sendevo/registrador-dinamometrico/readme.md

# Registrador dinamométrico para maquinarias agropecuarias

Dispositivo para el registro de datos de cuatro canales para celdas de cargas y cinco canales para contadores de pulso. El registrador se aplica para la medición de esfuerzos de tracción y velocidades de rotación de ejes o ruedas de maquinaria agrícola.

Está diseñado para alimentarse con batería de 12V, tolerancia para conexión invertida y con caída de tensión de hasta 10V. Posee reloj interno con vida útil de más de 5 años, almacenamiento de datos de hasta 4GB y conexión USB para la descarga de datos.

Se incluye el software para la configuración del registrador:
   - Listado de registros almacenados.  
   - Descarga de registros.  
   - Eliminación de registros.  
   - Lectura de celdas de carga.  
   - Configuración de fecha y hora.  

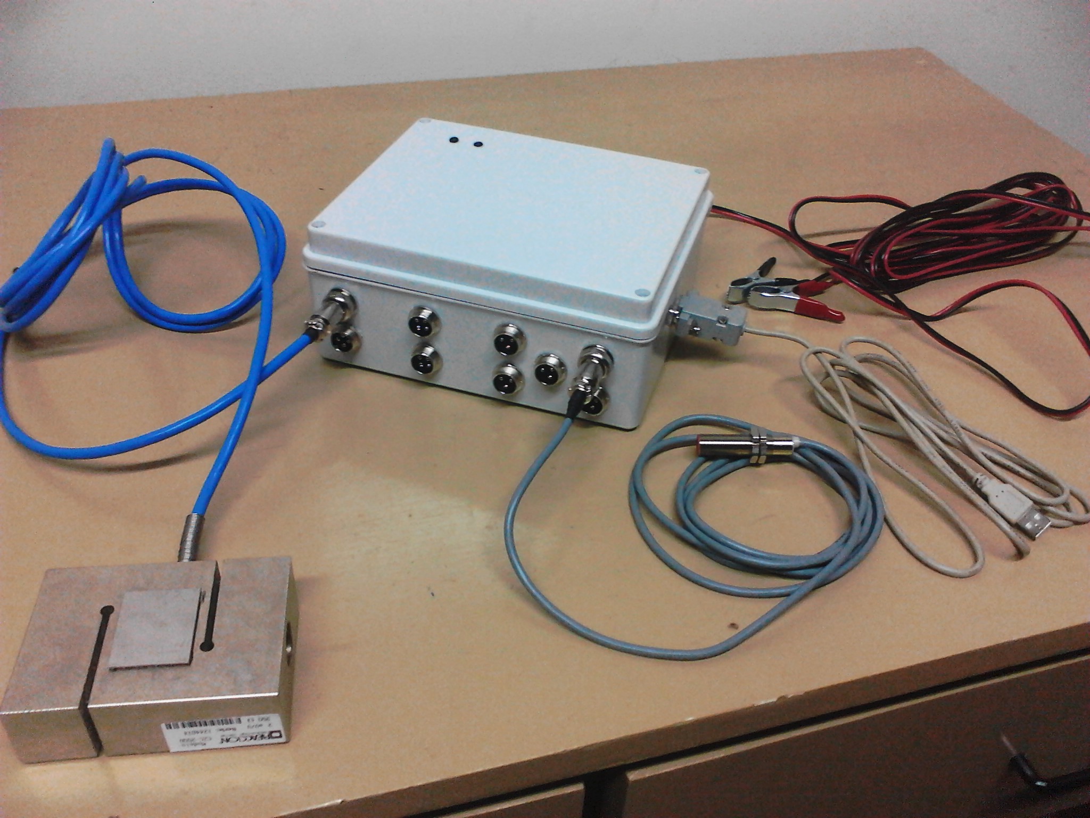
[picture p1: documentacion/fotos/IMG_20151119_213634.jpg]


## Esquema de bloques genérico
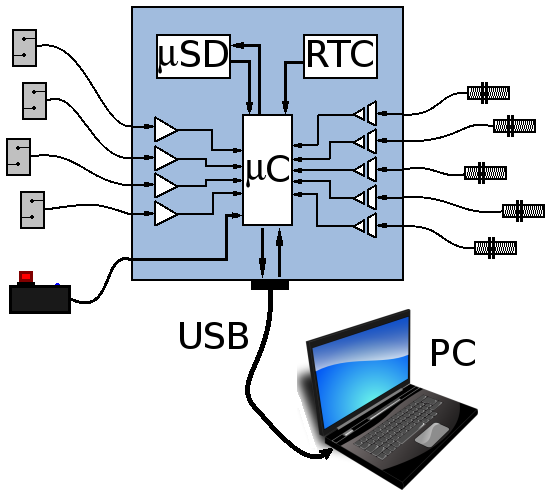
[picture p2: documentacion/manual-assets/Diagrama.png]


## Placa madre
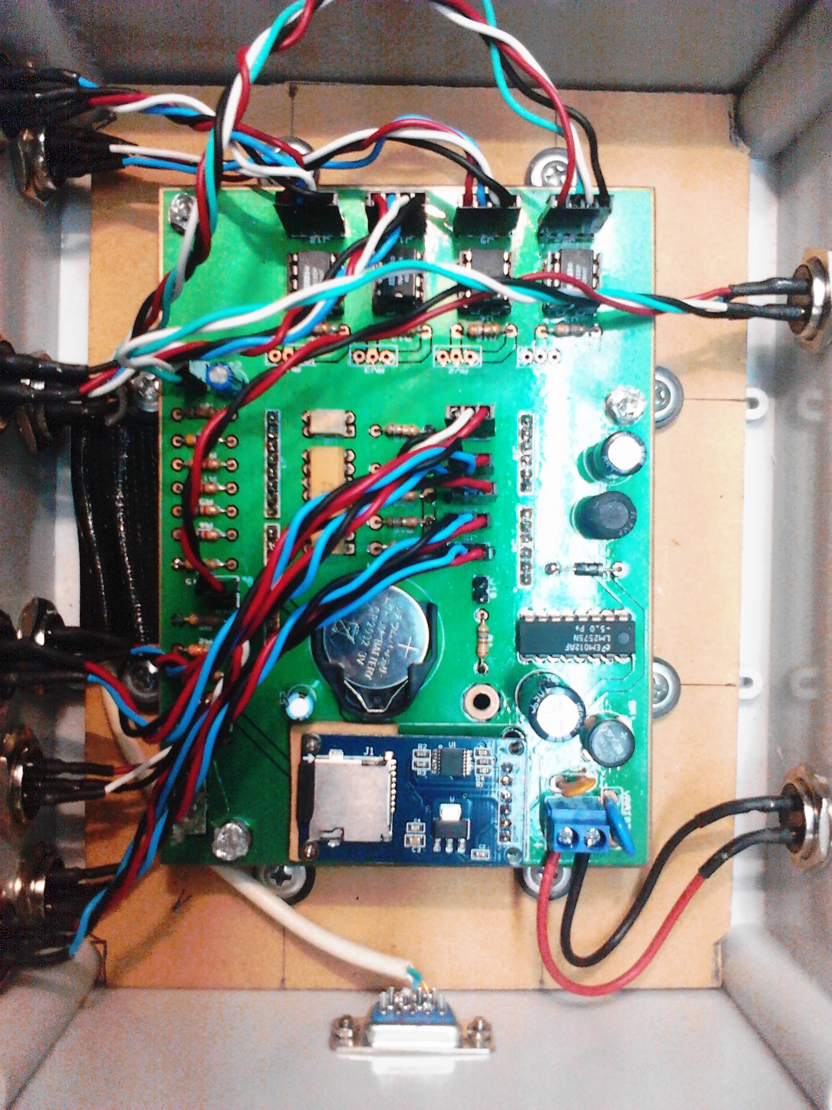
[picture p3: documentacion/fotos/IMG_20151201_174024.jpg]


## Circuito de celdas de carga
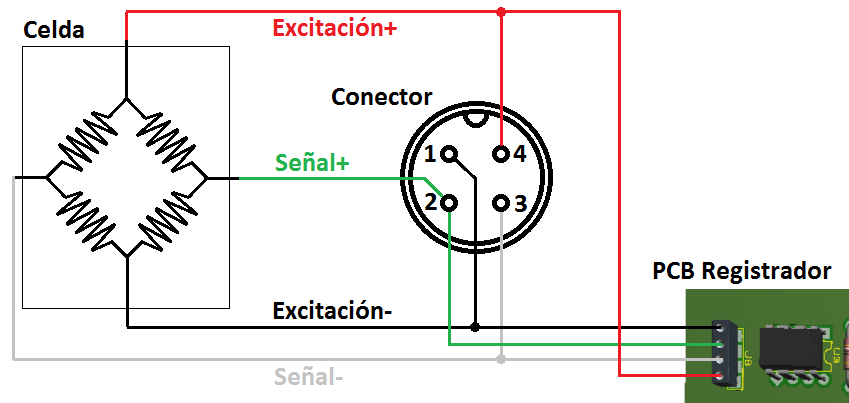
[picture p4: documentacion/manual-assets/ConectorCeldas.png]


## Circuito de contadores de pulso
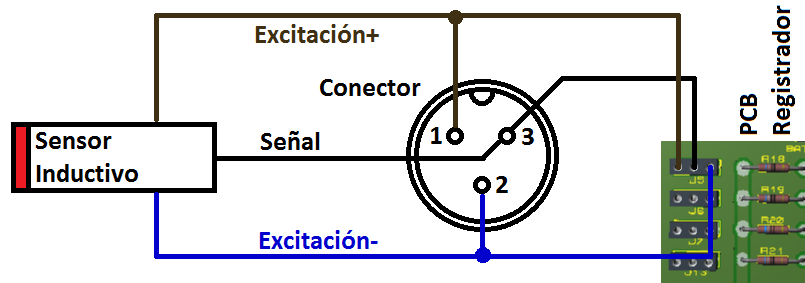
[picture p5: documentacion/manual-assets/ConectorInductivos.png]


## Versión actualizada

La nueva versión incluye un display de 20x4 para mostrar estado de las entradas en el caso de requerir mediciones no periódicas. Cuando el switch de activación se enciende, el display indica que el registrador se encuentra en modo de medición y registro de datos.  
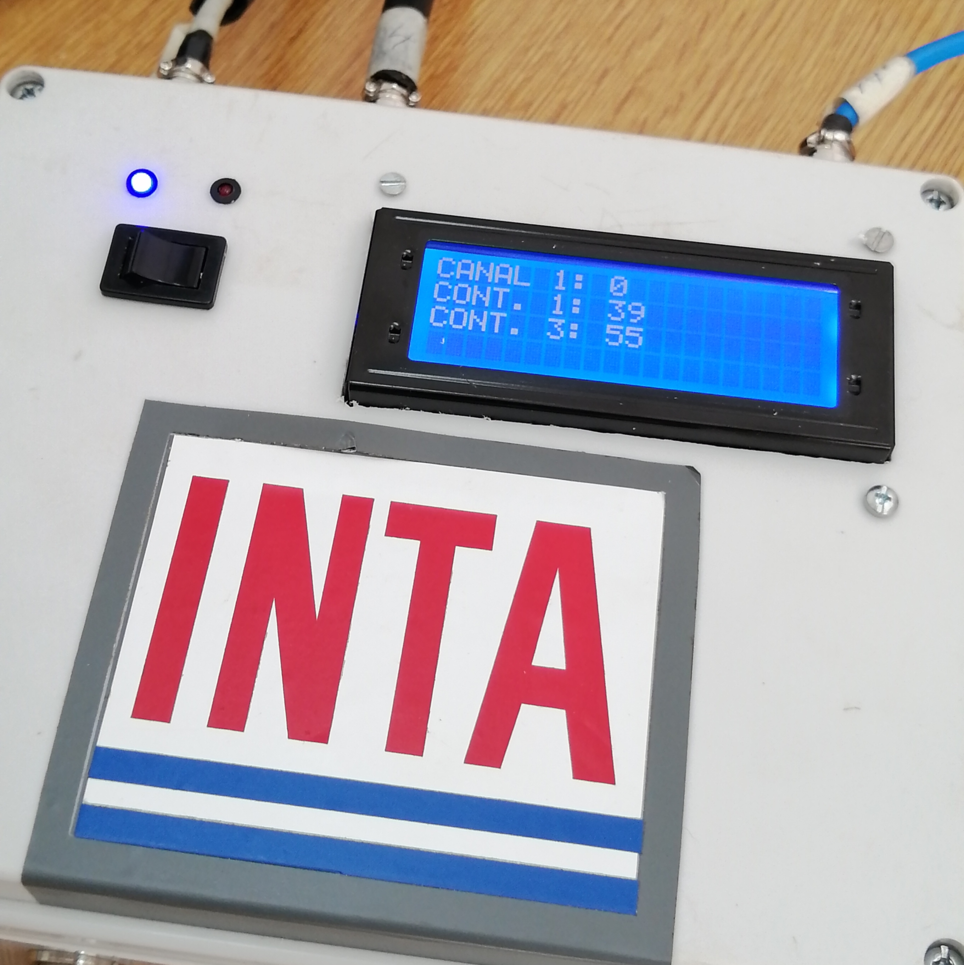
[picture p6: documentacion/fotos/IMG_20230531_140004_sq.jpg]


## Creación del ejecutable para windows

```bash
pyinstaller --onefile --windowed --icon=app_icon.ico --add-data "assets;assets" main.py
```
