sendevo/registrador-dinamometrico/documentacion/jaiio-cai-2016/slides-cai-2016.pdf

Diseño de un
Registrador de
Esfuerzos para
Maquinaria Agrícola

Introducción

Hardware
- Plataforma
- Medición de RPM
- Medición de
esfuerzos de
tracción
- Fuente de
alimentación
- Montaje

Software
- Firmware
- Software PC

Pruebas
experimentales

Conclusiones

# Diseño de un Registrador de Esfuerzos para Maquinaria Agrícola

# Gabriel M. Eggly – Matías J. Micheletto – Rodrigo M. Santos

# Dep. Ing. Eléctrica y Computadoras IIIE - Universidad Nacional del Sur CONICET

Diseño de un
Registrador de
Esfuerzos para
Maquinaria Agrícola

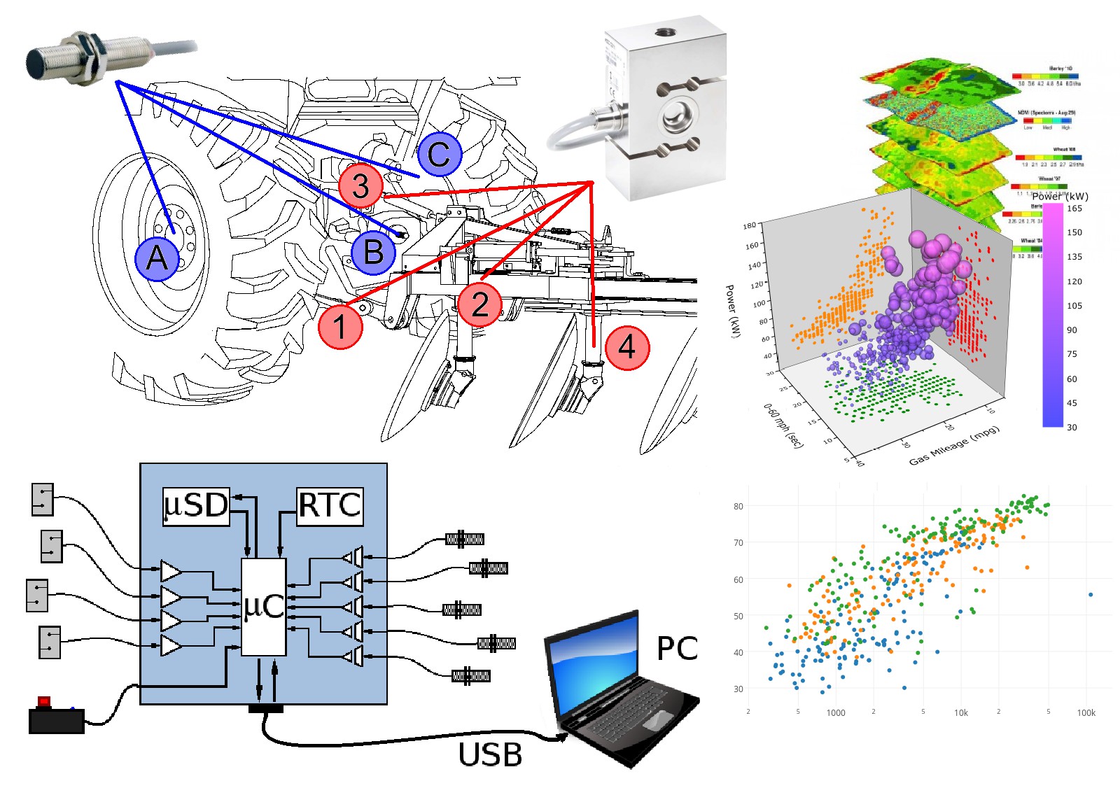
[picture p15: figure]

Introducción

Hardware
- Plataforma
- Medición de RPM
- Medición de
esfuerzos de
tracción
- Fuente de
alimentación
- Montaje

Software
- Firmware
- Software PC

Pruebas
experimentales

Conclusiones

# Introducción

Diseño de un
Registrador de
Esfuerzos para
Maquinaria Agrícola

Introducción

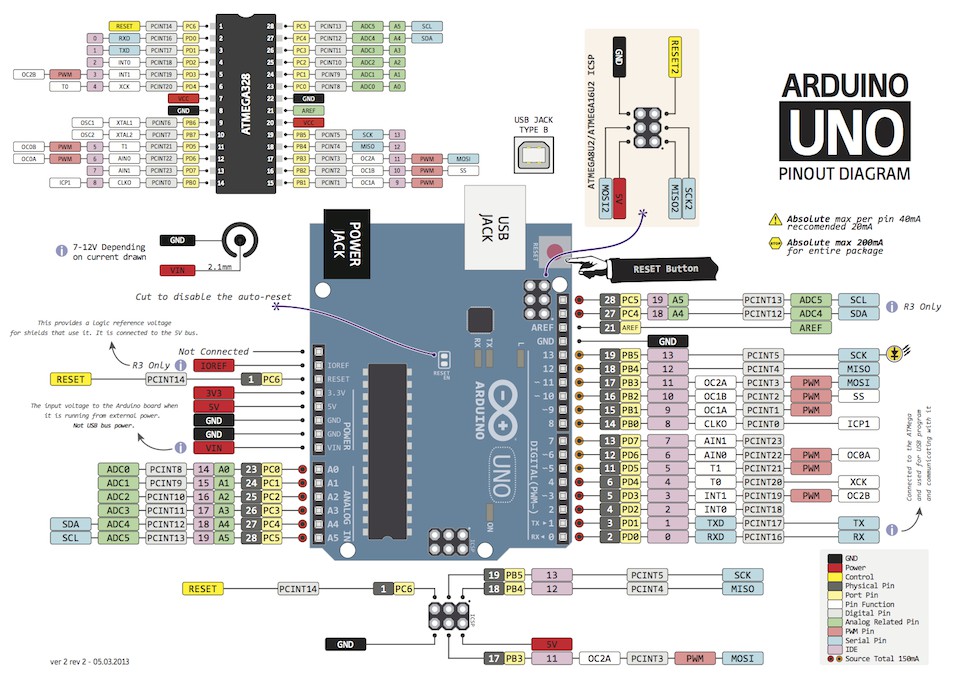
[picture p16: figure]

Hardware
- Plataforma
- Medición de RPM
- Medición de
esfuerzos de
tracción
- Fuente de
alimentación
- Montaje

Software
- Firmware
- Software PC

Pruebas
experimentales

Conclusiones

# Hardware

# Plataforma

Diseño de un
Registrador de
Esfuerzos para
Maquinaria Agrícola

Introducción

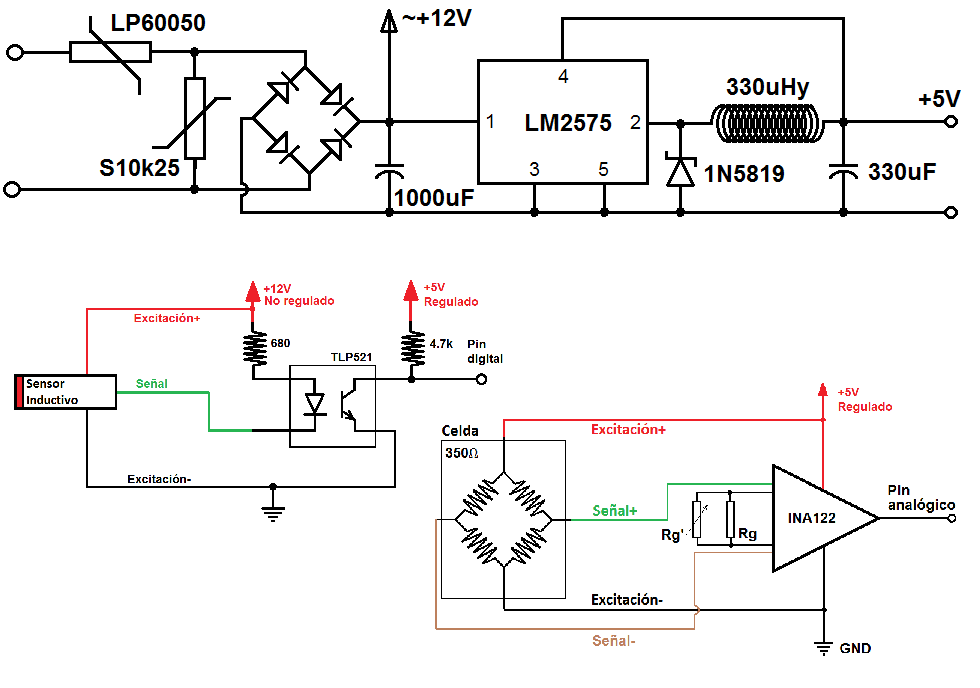
[picture p17: figure]

Hardware
- Plataforma
- Medición de RPM
- Medición de
esfuerzos de
tracción
- Fuente de
alimentación
- Montaje

Software
- Firmware
- Software PC

Pruebas
experimentales

Conclusiones

# Hardware

# Fuente de alimentación y sensores

Diseño de un
Registrador de
Esfuerzos para
Maquinaria Agrícola

Introducción

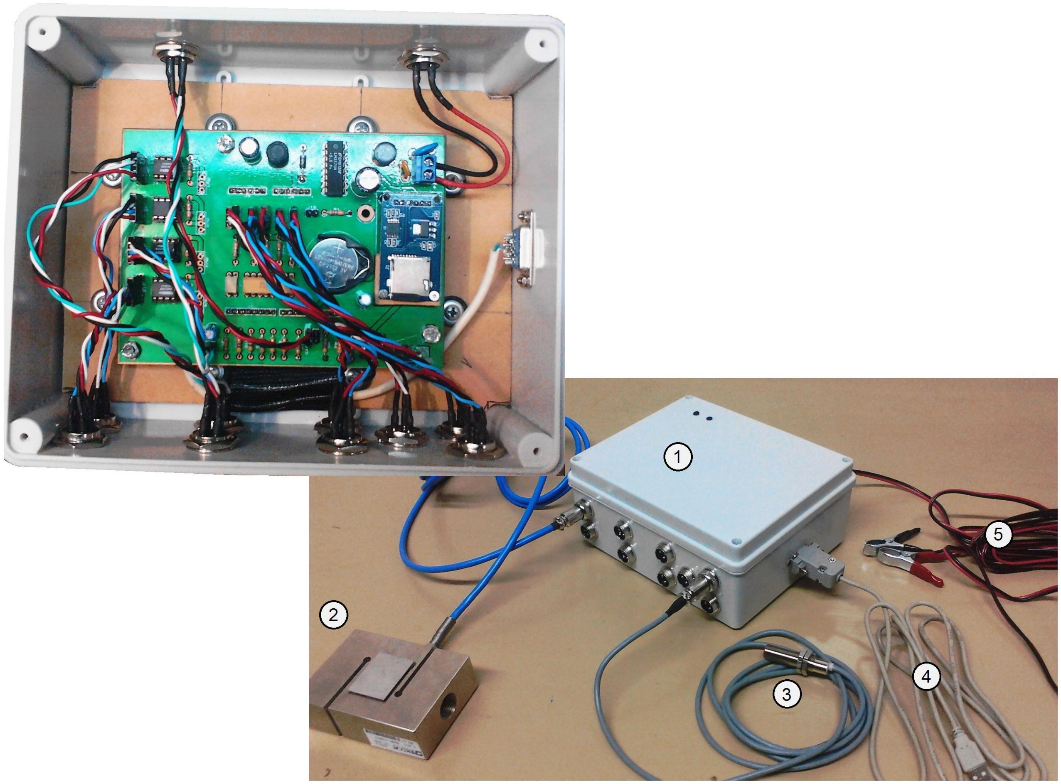
[picture p18: figure]

Hardware
- Plataforma
- Medición de RPM
- Medición de
esfuerzos de
tracción
- Fuente de
alimentación
- Montaje

Software
- Firmware
- Software PC

Pruebas
experimentales

Conclusiones

# Hardware

# Montaje

# Software

# Firmware

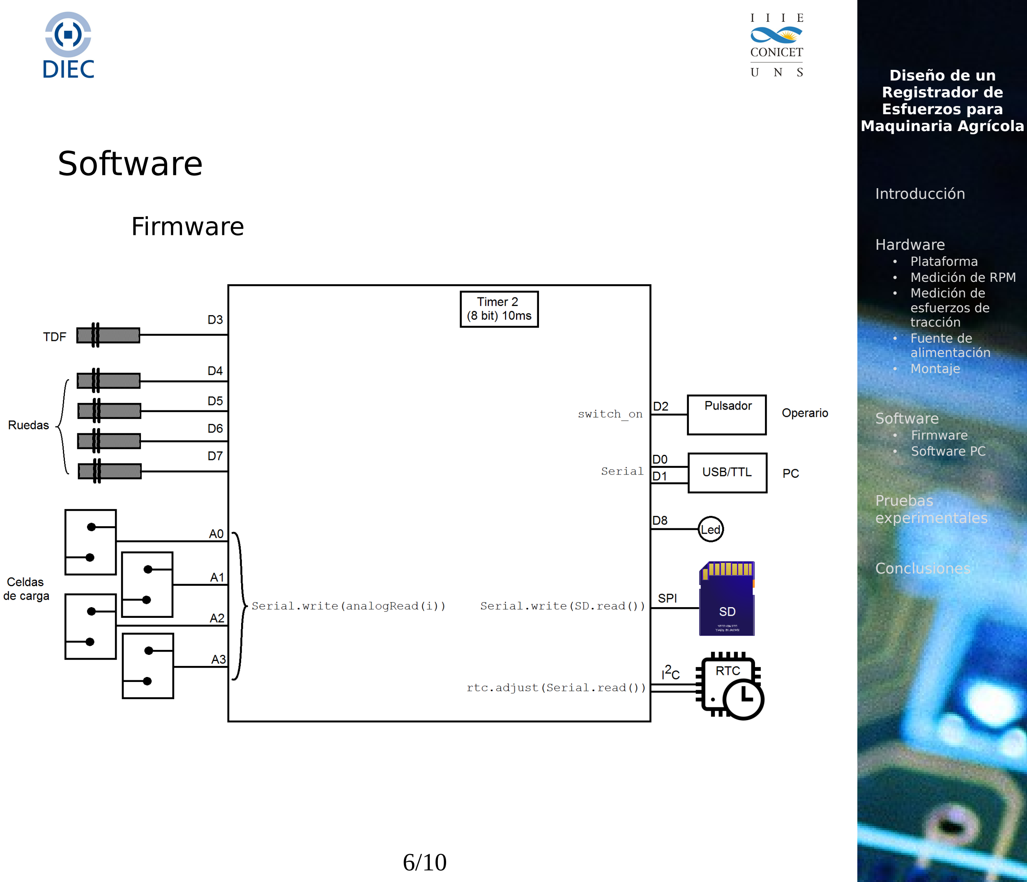
[picture p19: page 6]

Diseño de un
Registrador de
Esfuerzos para
Maquinaria Agrícola

Introducción

Hardware
- Plataforma
- Medición de RPM
- Medición de
esfuerzos de
tracción
- Fuente de
alimentación
- Montaje

Software
- Firmware
- Software PC

Pruebas
experimentales

Conclusiones

# Software

# Firmware

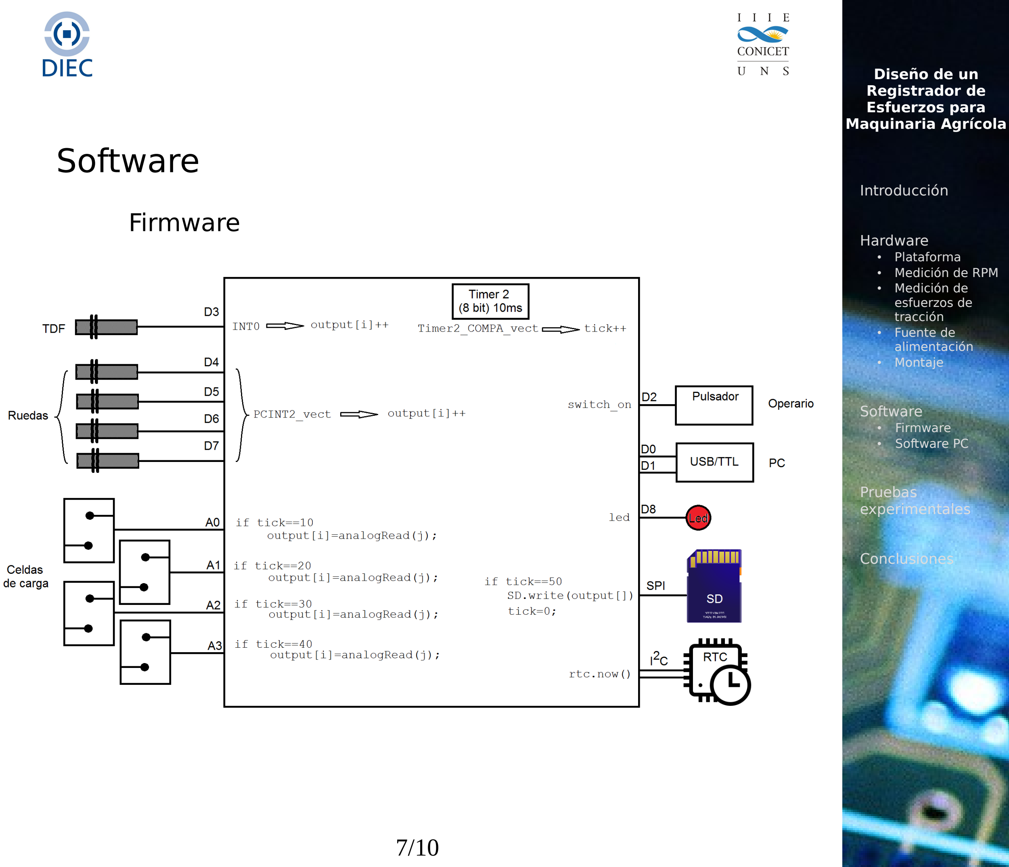
[picture p20: page 7]

Diseño de un
Registrador de
Esfuerzos para
Maquinaria Agrícola

Introducción

Hardware
- Plataforma
- Medición de RPM
- Medición de
esfuerzos de
tracción
- Fuente de
alimentación
- Montaje

Software
- Firmware
- Software PC

Pruebas
experimentales

Conclusiones

# Software

# Driver para PC

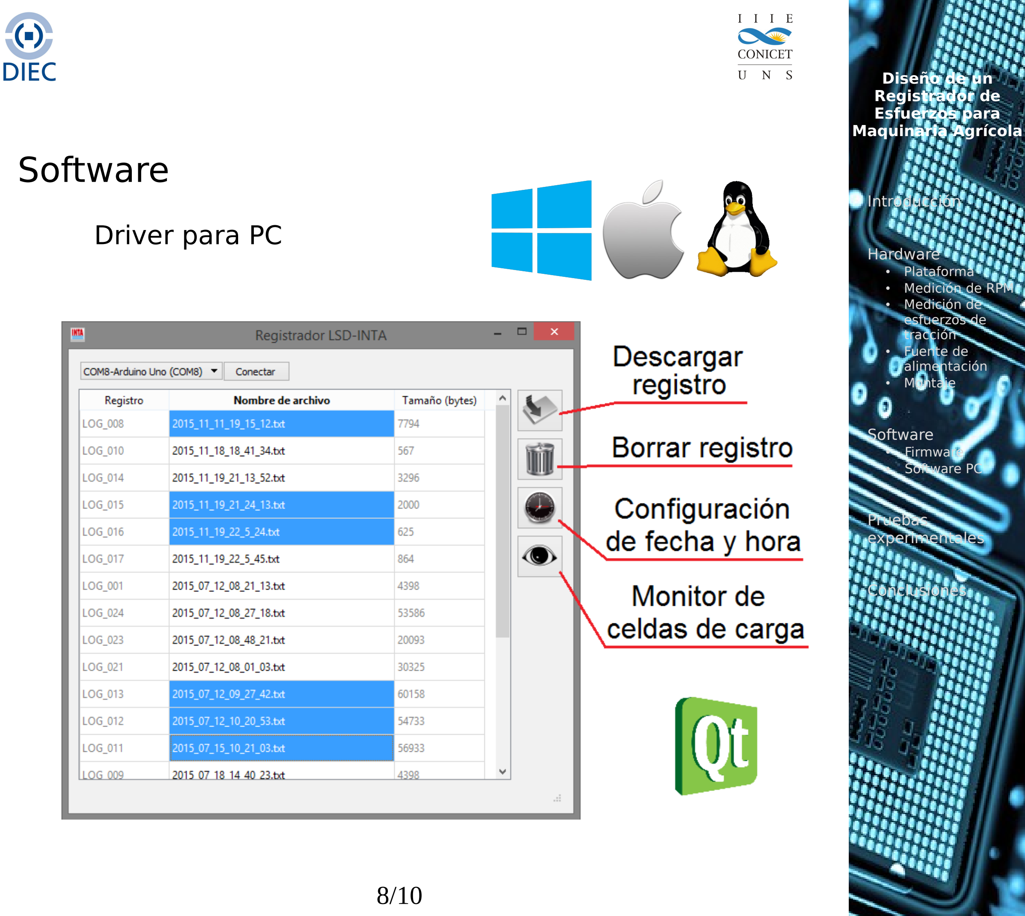
[picture p21: page 8]

Diseño de un
Registrador de
Esfuerzos para
Maquinaria Agrícola

Introducción

Hardware
- Plataforma
- Medición de RPM
- Medición de
esfuerzos de
tracción
- Fuente de
alimentación
- Montaje

Software
- Firmware
- Software PC

Pruebas
experimentales

Conclusiones

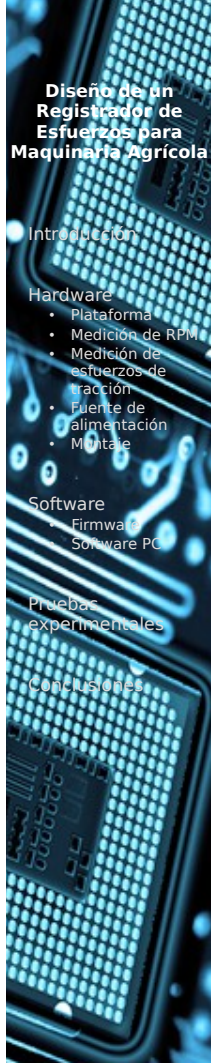
[picture p22: figure]
Diseño de un Registrador de Esfuerzos para Maquinaria Agrícola; Introducción; Hardware • Plataforma • Medición de RPM • Medición de esfuerzos de tracción • Fuente de alimentación • Montaje; Software • Firmware • Software PC; Pruebas experimentales; Conclusiones

# Conclusiones

- Diseño simple y económico.
- Fácil instalación, puesta en marcha y uso.

# - No requiere software específico para la descarga de

datos (protocolo de comunicación abierto).

# - Requiere software adicional para el análisis de los

datos.

Diseño de un
Registrador de
Esfuerzos para
Maquinaria Agrícola

Introducción

Hardware
- Plataforma
- Medición de RPM
- Medición de
esfuerzos de
tracción
- Fuente de
alimentación
- Montaje

Software
- Firmware
- Software PC

Pruebas
experimentales

Conclusiones

# Diseño de un Registrador de Esfuerzos para Maquinaria Agrícola

# Gabriel M. Eggly – Matías J. Micheletto – Rodrigo M. Santos

# Dep. Ing. Eléctrica y Computadoras IIIE - Universidad Nacional del Sur CONICET
