sendevo/registrador-dinamometrico/documentacion/fotos/IMG_20151119_201550.jpg

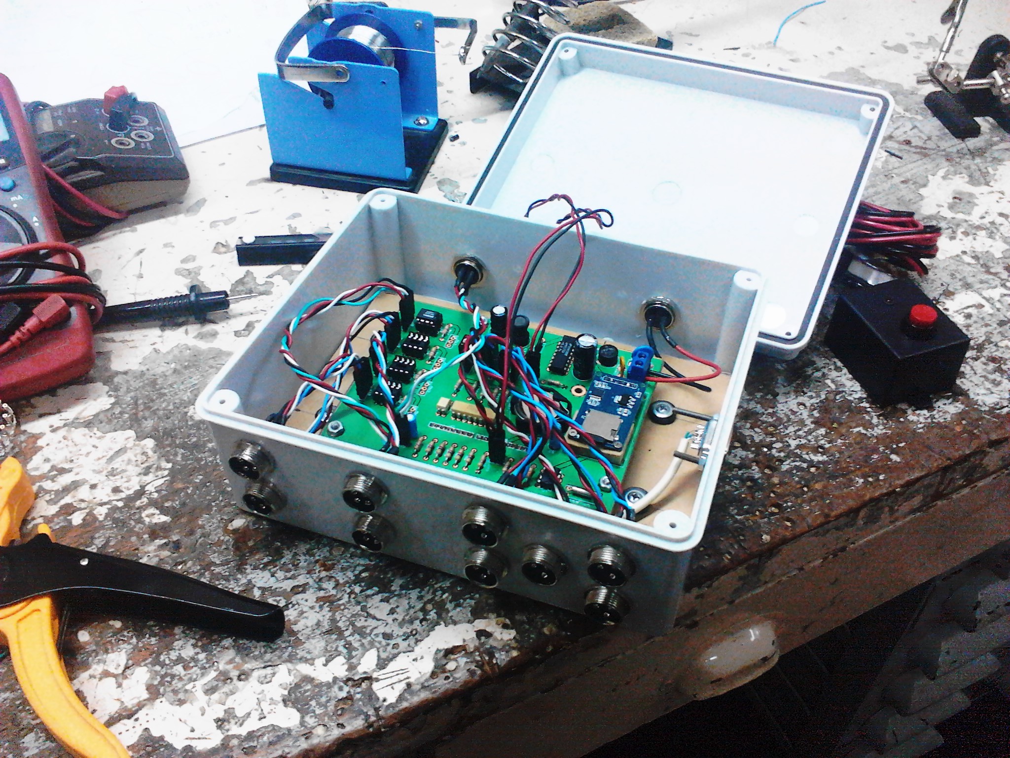
documentacion/fotos/IMG_20151119_201550.jpg
