sendevo/registrador-dinamometrico/documentacion/fotos/IMG_20230531_140004.jpg

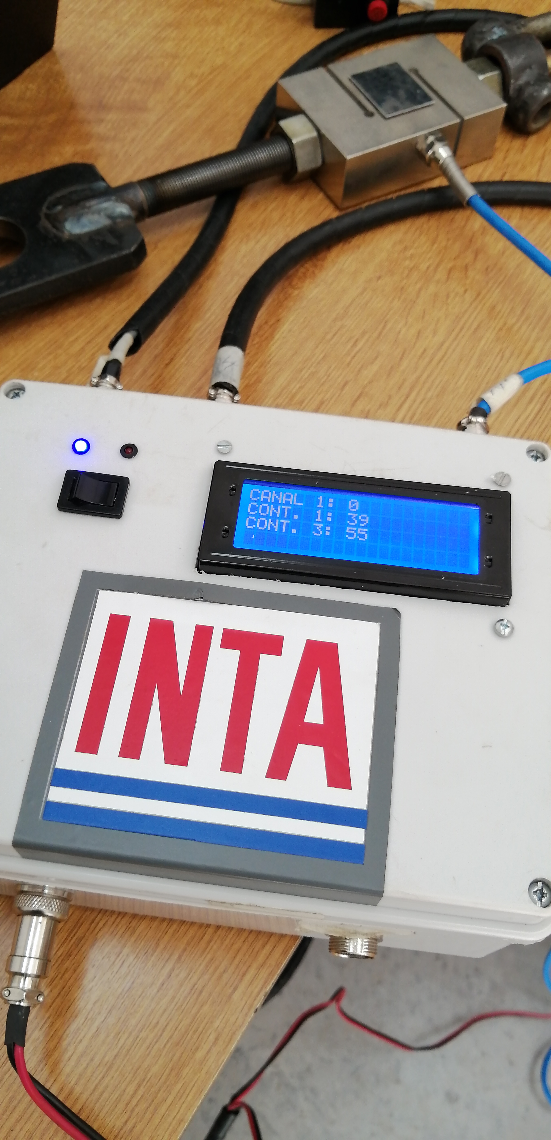
documentacion/fotos/IMG_20230531_140004.jpg
