sendevo/registrador-dinamometrico/software/windows-vs/Inta.png

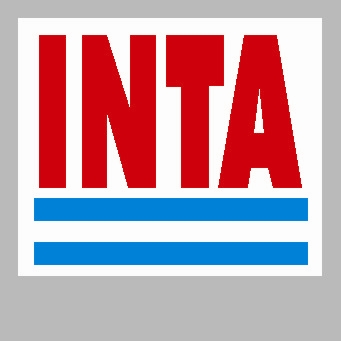
software/windows-vs/Inta.png
