sendevo/registrador-dinamometrico/documentacion/manual-assets/2_ListaArchivos.png

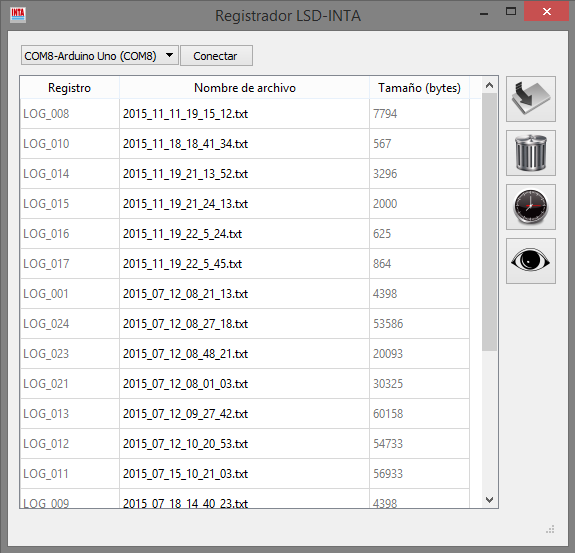
documentacion/manual-assets/2_ListaArchivos.png
