sendevo/registrador-dinamometrico/documentacion/manual-assets/CarcasaRegistrado3.png

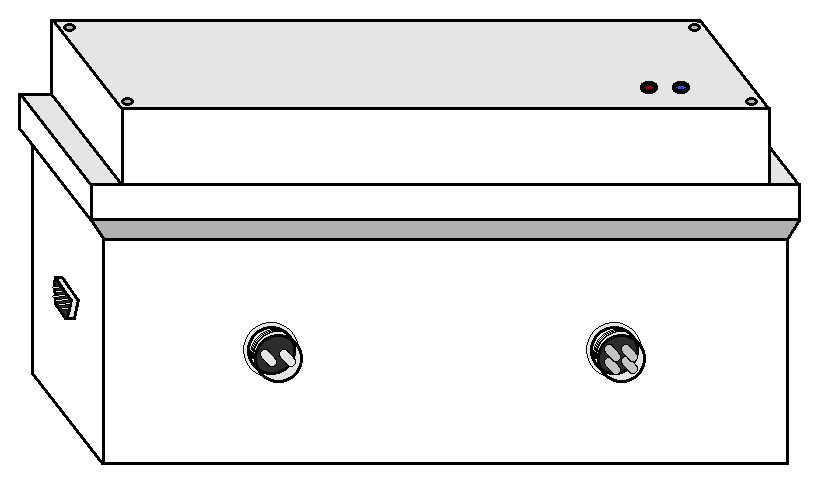
documentacion/manual-assets/CarcasaRegistrado3.png
