sendevo/registrador-dinamometrico/documentacion/manual-assets/CarcasaRegistrado6.png

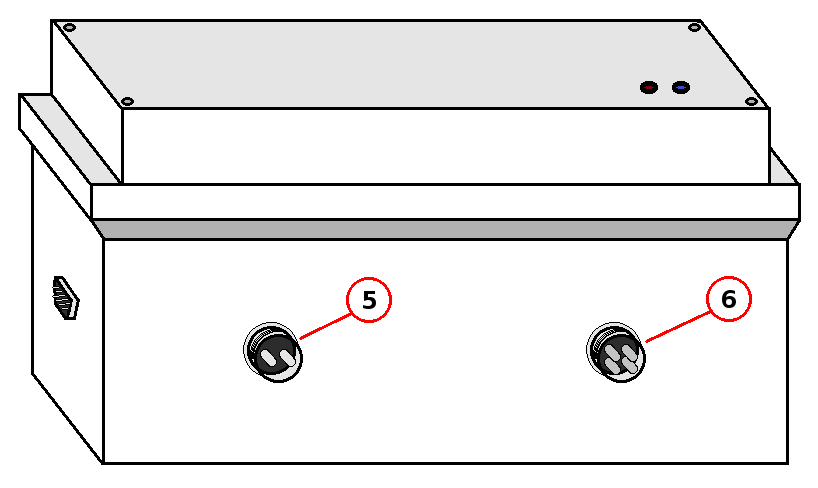
documentacion/manual-assets/CarcasaRegistrado6.png
