sendevo/registrador-dinamometrico/documentacion/manual-assets/CarcasaRegistrador2.png

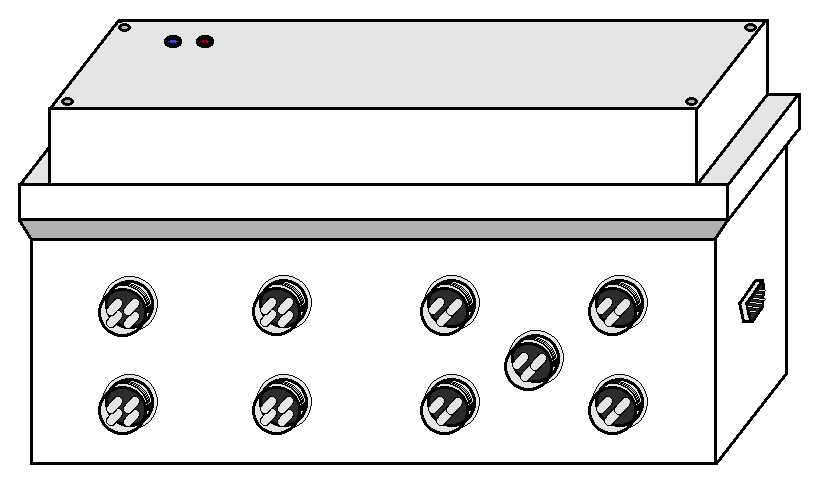
documentacion/manual-assets/CarcasaRegistrador2.png
