sendevo/registrador-dinamometrico/documentacion/manual-assets/CarcasaRegistrador5.png

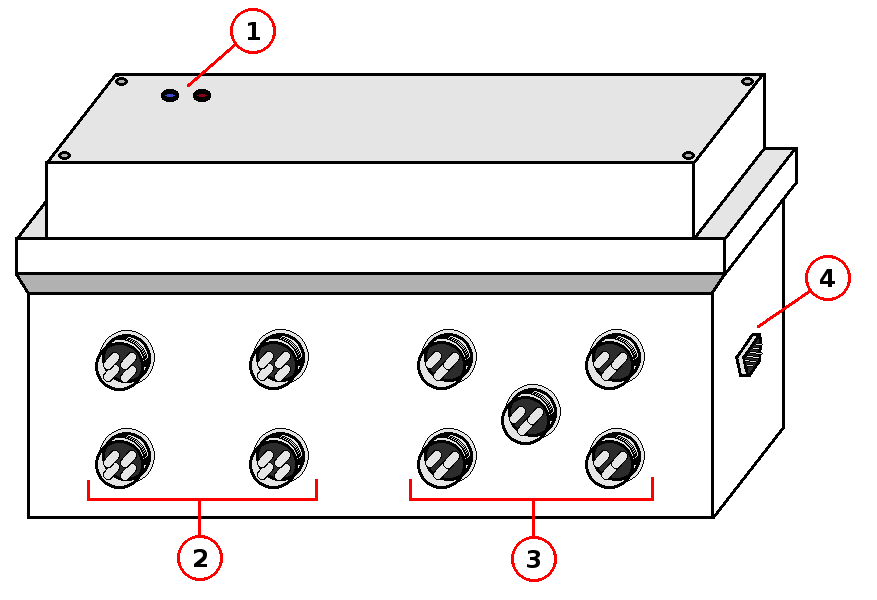
documentacion/manual-assets/CarcasaRegistrador5.png
