sendevo/registrador-dinamometrico/documentacion/manual-assets/CarcasaRegistrador.png

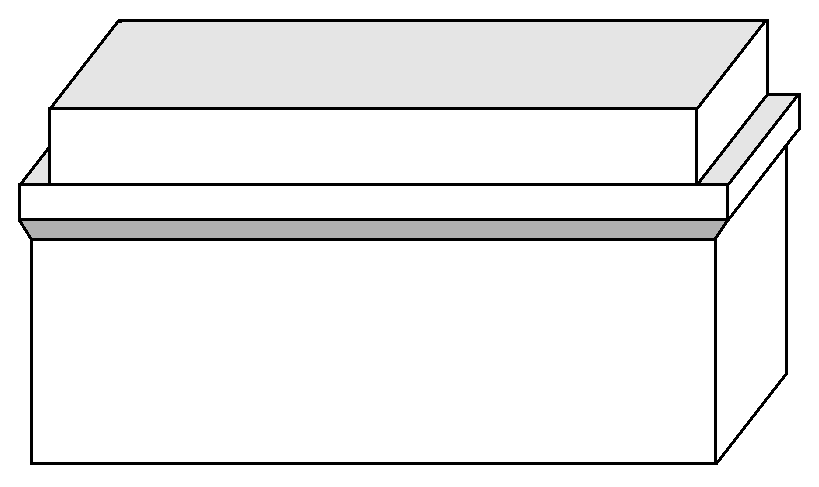
documentacion/manual-assets/CarcasaRegistrador.png
