sendevo/registrador-dinamometrico/documentacion/manual-assets/Catalex-MicroSD-Module.png

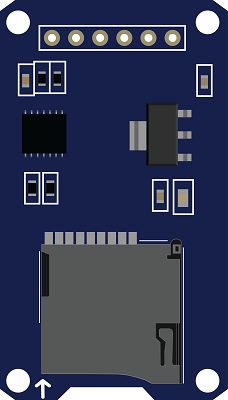
documentacion/manual-assets/Catalex-MicroSD-Module.png
