sendevo/registrador-dinamometrico/documentacion/manual-assets/Conectores.png

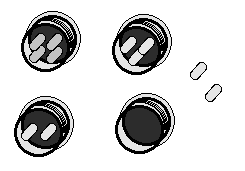
documentacion/manual-assets/Conectores.png
