sendevo/registrador-dinamometrico/documentacion/manual-assets/Connector-db9.png

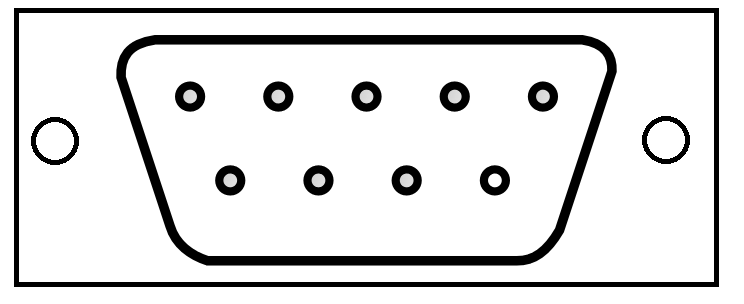
documentacion/manual-assets/Connector-db9.png
