sendevo/registrador-dinamometrico/documentacion/manual-assets/Pulsador.png

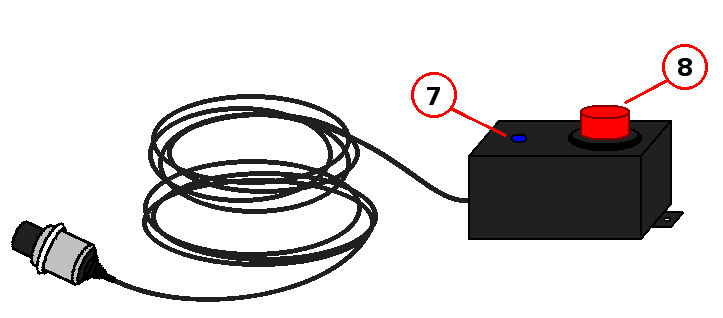
documentacion/manual-assets/Pulsador.png
