sendevo/registrador-dinamometrico/documentacion/manual-assets/UNS.png

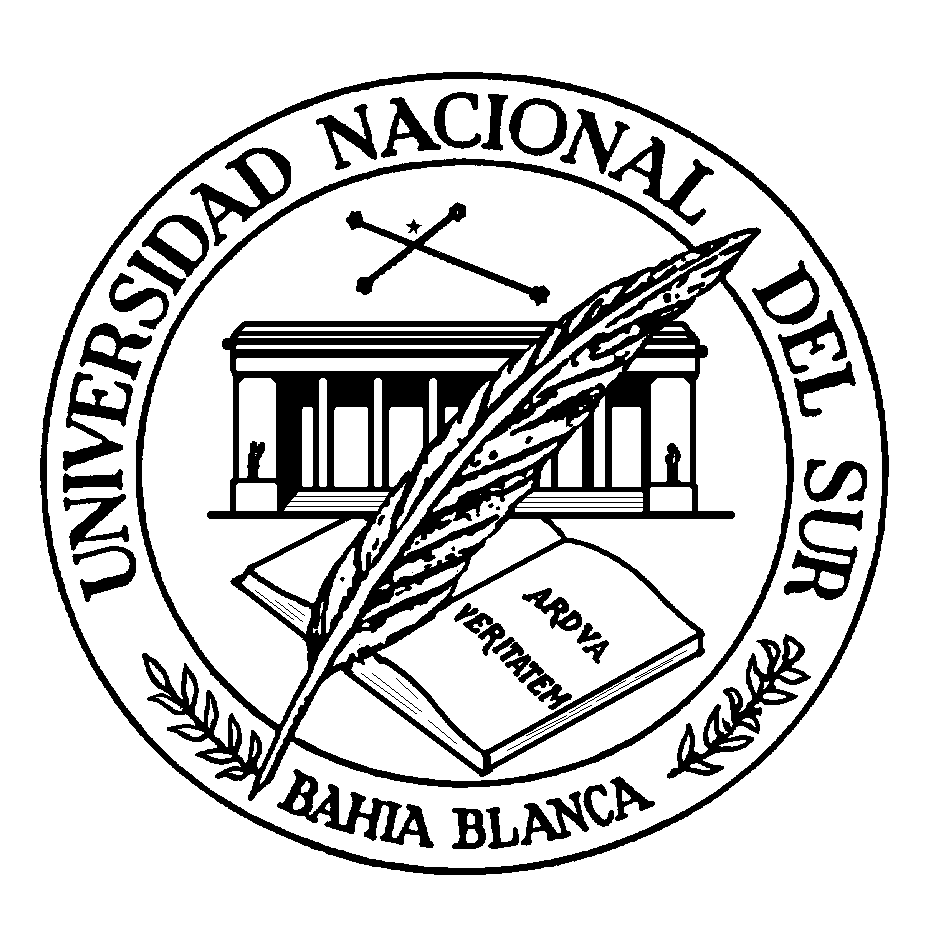
documentacion/manual-assets/UNS.png
