sendevo/registrador-dinamometrico/hardware/caja-estanca.pdf

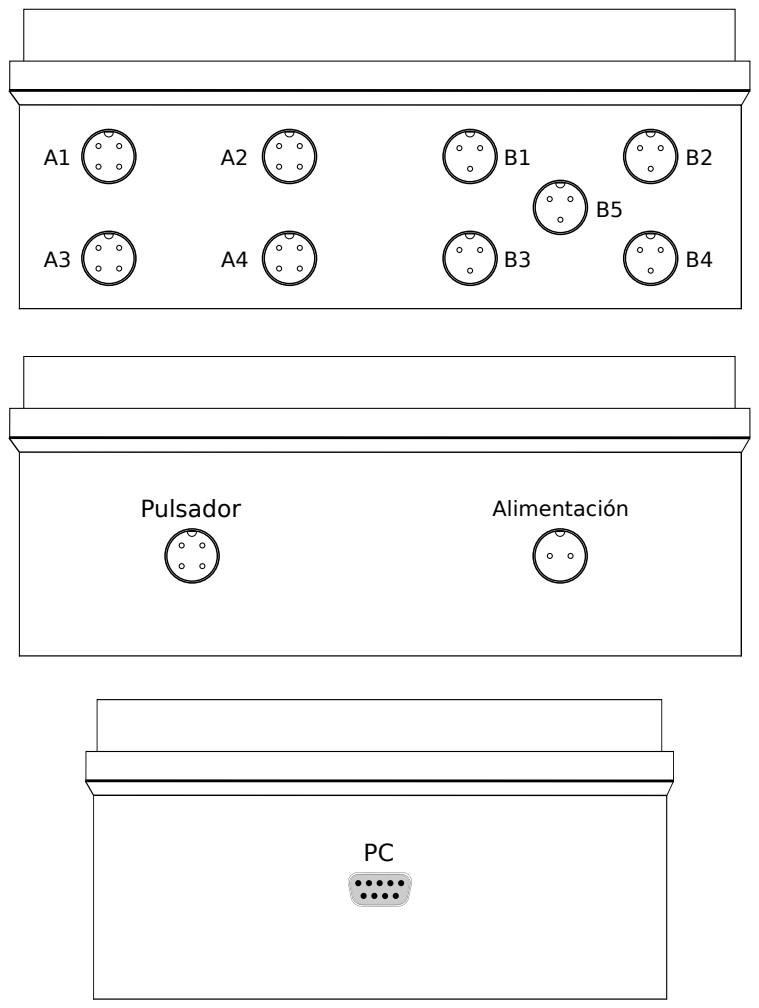
[picture p48: page 1]
Pulsador; Alimentación
