sendevo/registrador-dinamometrico/hardware/pcb-inferior.pdf

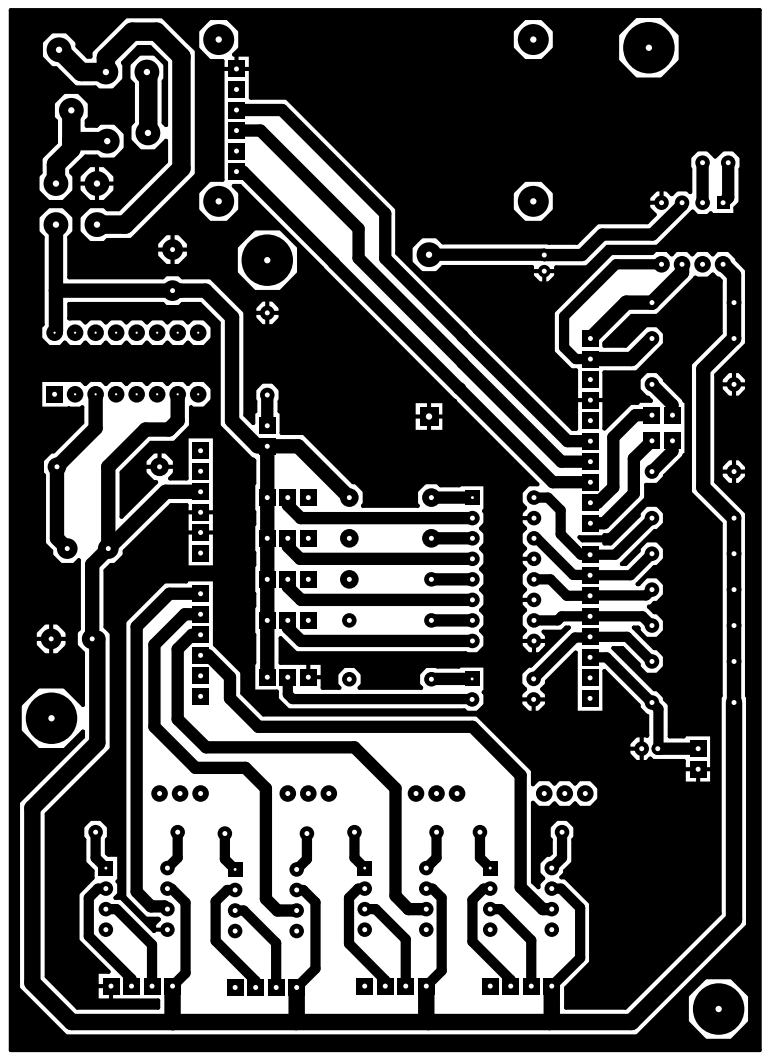
[picture p49: page 1]
