sendevo/registrador-dinamometrico/hardware/pcb-superior.pdf

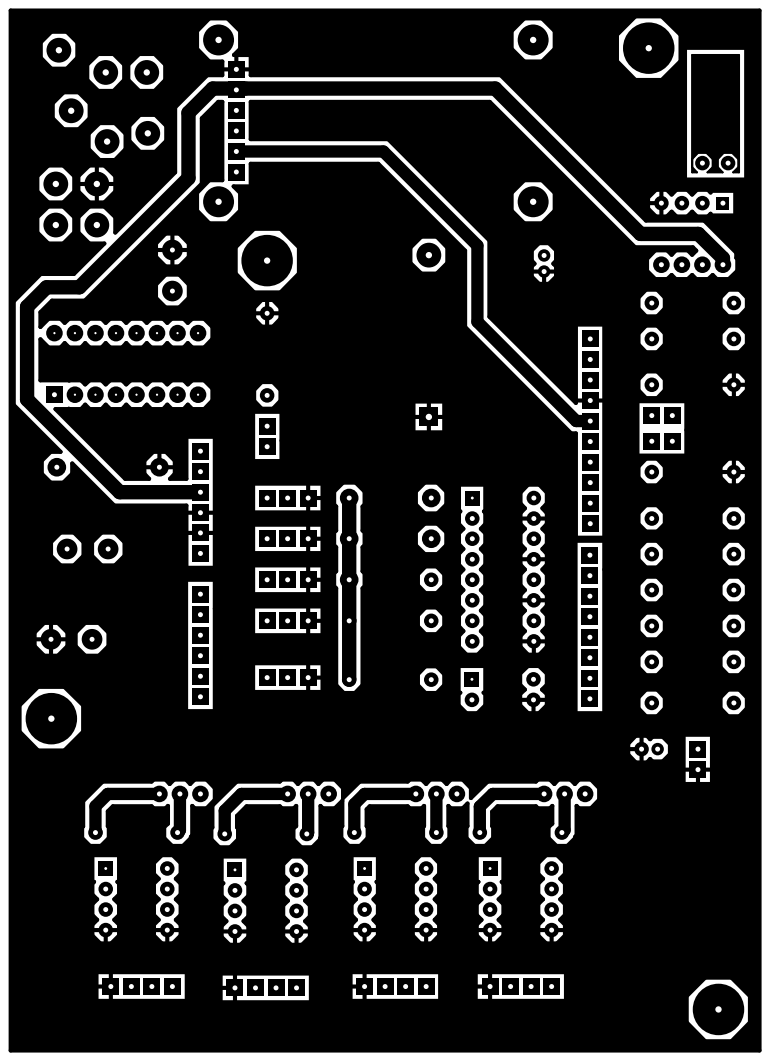
[picture p50: page 1]
