sendevo/registrador-dinamometrico/(list of files, drawings)

Other design files:
hardware/proteus-harware.pdsprj
