sendevo/registrador-dinamometrico/(commit log)

2025-04-28 Contenido del proyecto 2016
    [proteus-harware.pdsprj]
2025-05-05 Software windows: ventana en blanco y snippets de ejemplos
2025-05-05 Combobox para seleccionar puerto serie
2025-05-05 Version 2 del firmware. Firmware emulador para probar comunicacion con el software.
2025-05-05 Fix dict en app_setup. Funcion de descarga de registros
    [main.py]
2025-05-06 Nuevos componentes de la ventana para el software. Aun no funciona la descarga de registros
2025-05-06 Cambio en el flujo de actualizacion de registros en la tabla del software
2025-05-06 Librerias de python para el software
2025-05-07 Software windows: mejora de busqueda automatica de puerto
2025-05-07 Acciones de descarga y eliminacion de registros y configuracion de fecha y hora
2025-05-07 Fix ajuste de fecha y hora desde el software y en firmware emulador
    [emulador.ino, main.py]
2025-05-08 Renombrado carpeta windows -> windows-vs para proyecto vs y archivo commands.py -> serial_manager.py. Compilacion a ejecutables
